MariosVasileiou/EDUV/Website/images/aegean.png

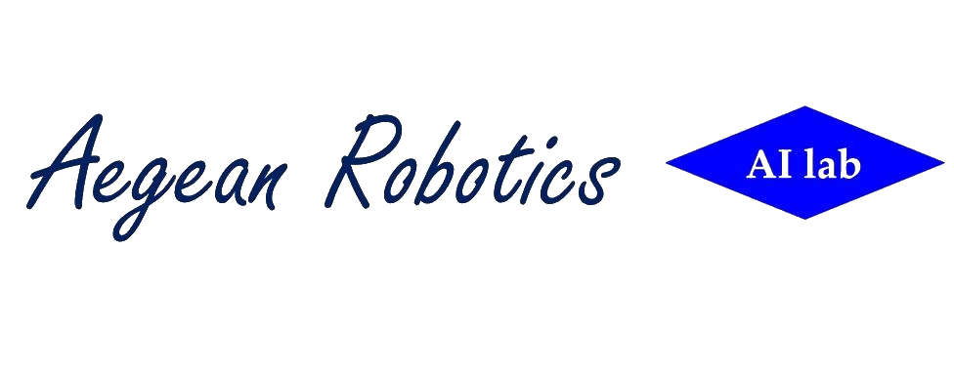
Website/images/aegean.png
