MariosVasileiou/EDUV/Website/images/animation.gif

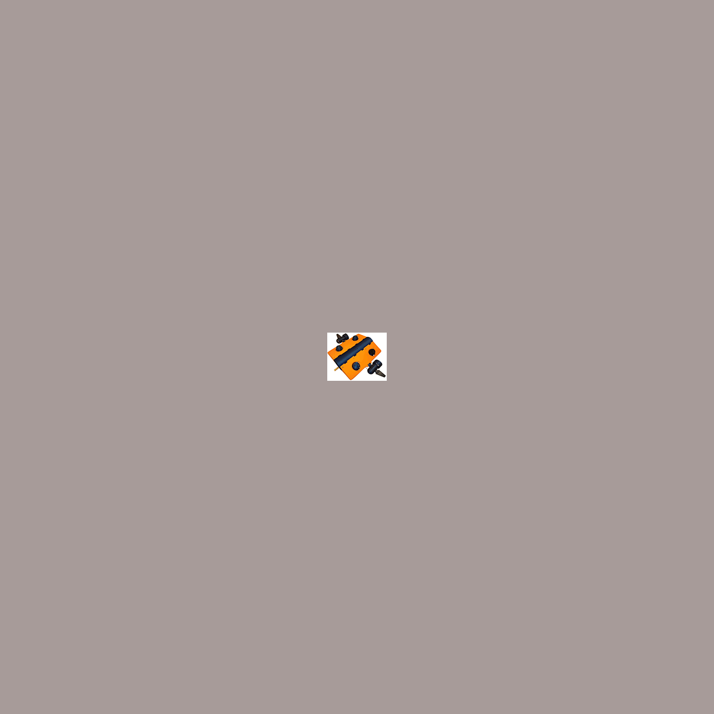
Website/images/animation.gif
