MariosVasileiou/EDUV/Website/images/EDUVButton.png

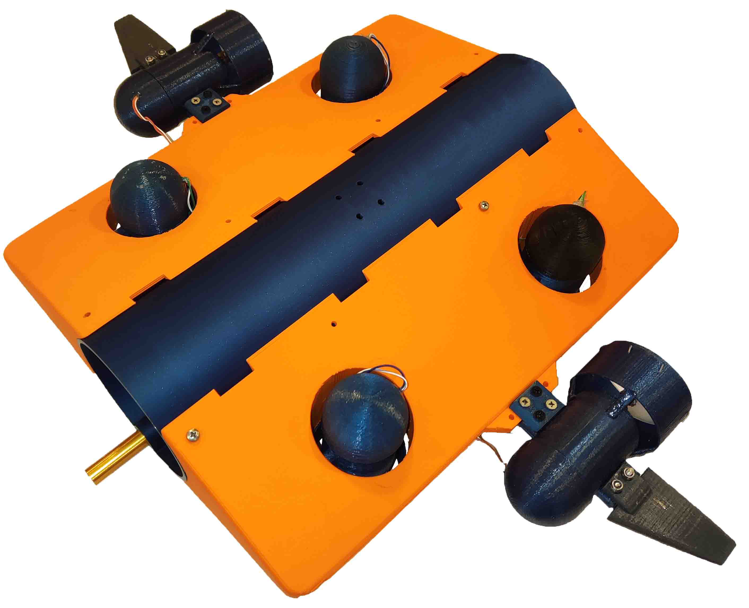
Website/images/EDUVButton.png
