MariosVasileiou/EDUV/Website/images/elgrecoPlay.png

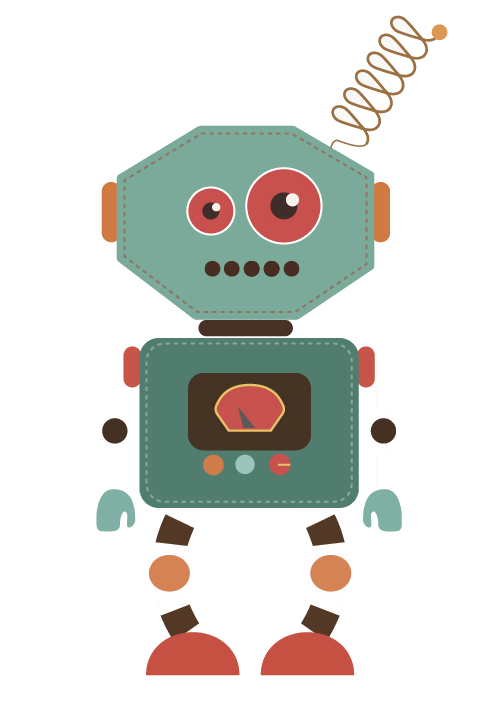
Website/images/elgrecoPlay.png
