MariosVasileiou/EDUV/Website/images/empty - Copy.png

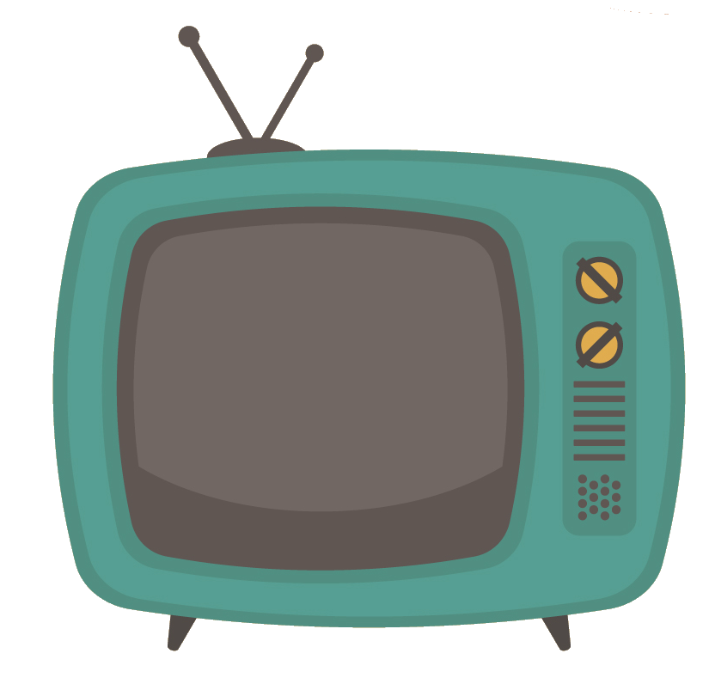
Website/images/empty - Copy.png
