MariosVasileiou/EDUV/Website/images/end.png

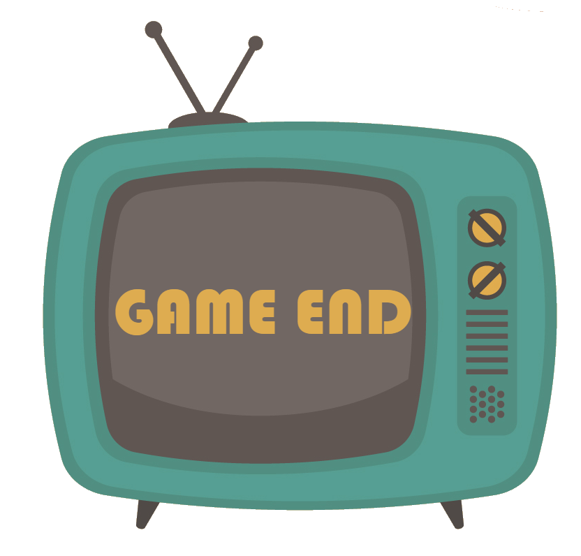
Website/images/end.png
