MariosVasileiou/EDUV/Website/images/fail.png

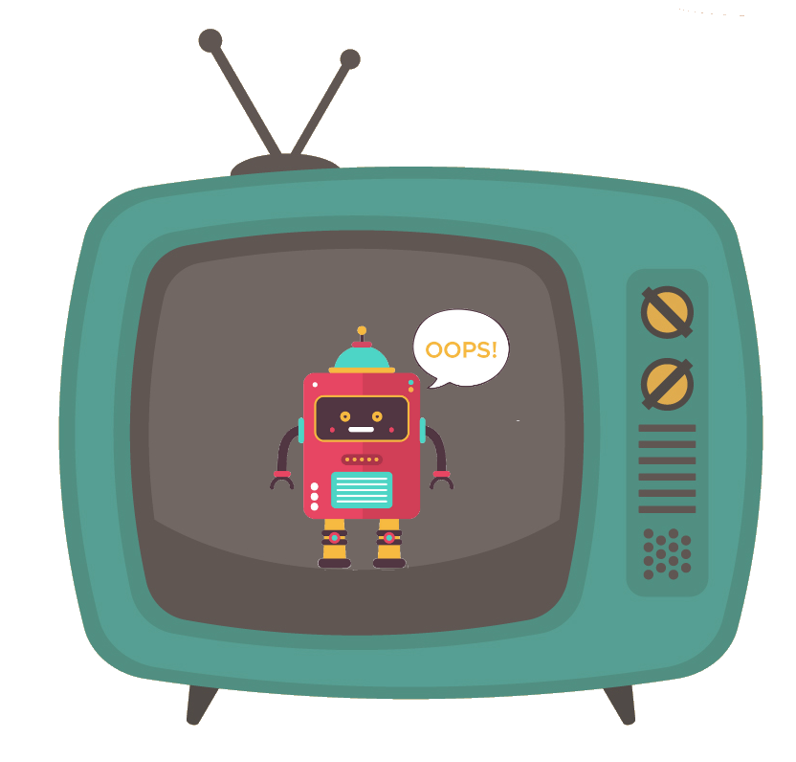
Website/images/fail.png
