MariosVasileiou/EDUV/Website/images/info2.png

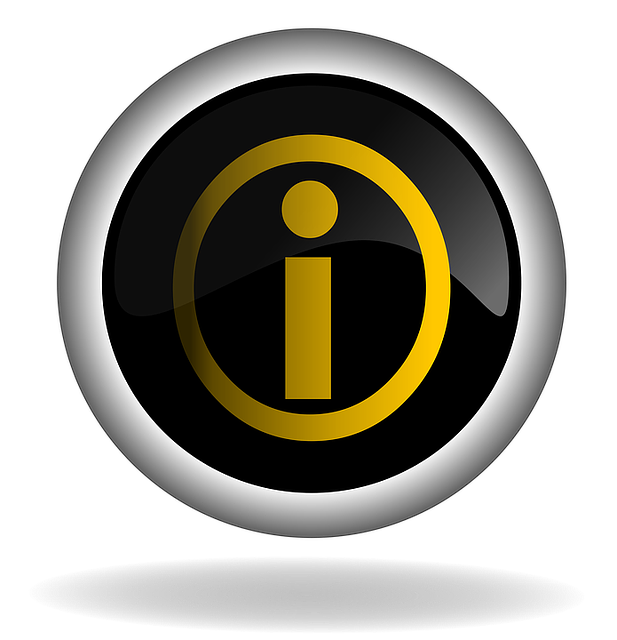
Website/images/info2.png
