MariosVasileiou/EDUV/Website/images/introtext.gif

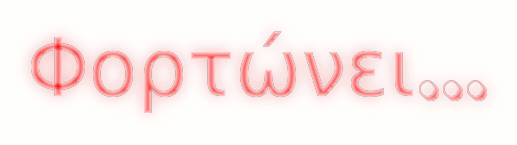
Website/images/introtext.gif
