MariosVasileiou/EDUV/Website/images/map.jpg

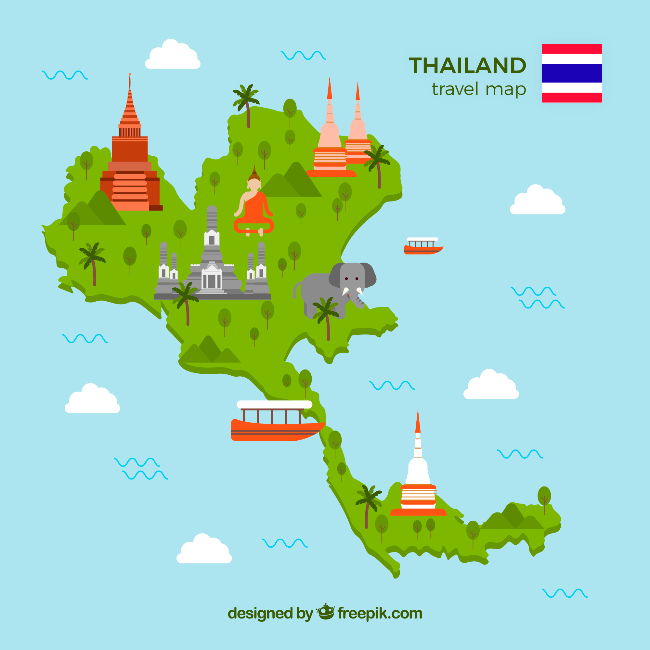
Website/images/map.jpg
