MariosVasileiou/EDUV/Website/images/pushbutton.png

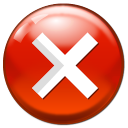
Website/images/pushbutton.png
