MariosVasileiou/EDUV/Website/images/rb1.png

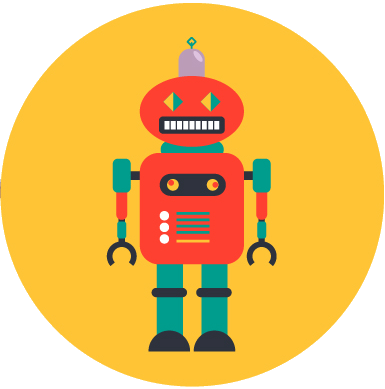
Website/images/rb1.png
