MariosVasileiou/EDUV/Website/images/rb2.png

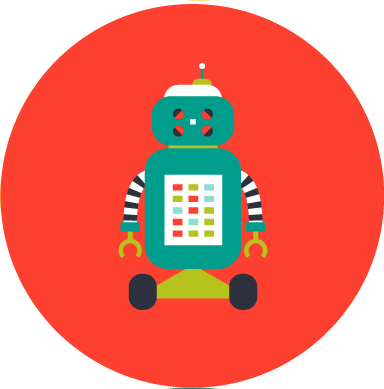
Website/images/rb2.png
