MariosVasileiou/EDUV/Website/images/rb3.png

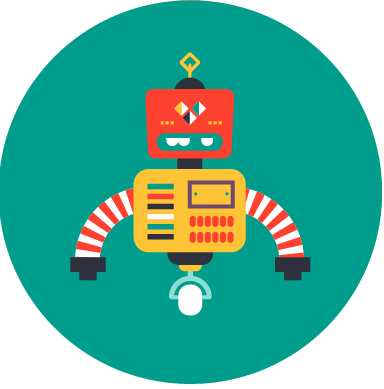
Website/images/rb3.png
