MariosVasileiou/EDUV/Website/images/slider1.jpg

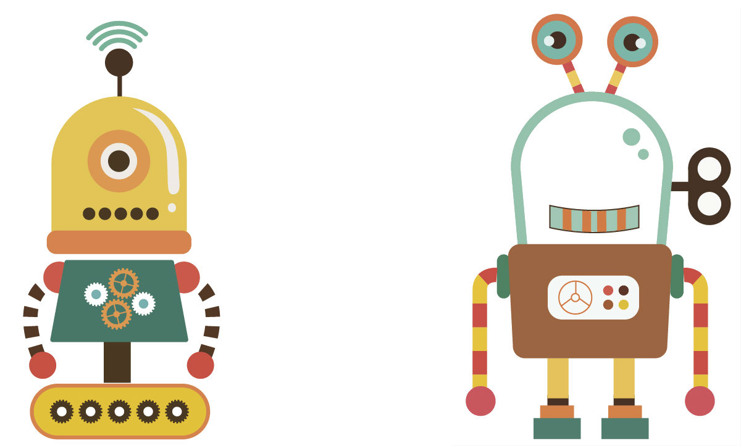
Website/images/slider1.jpg
