MariosVasileiou/EDUV/Website/images/start.png

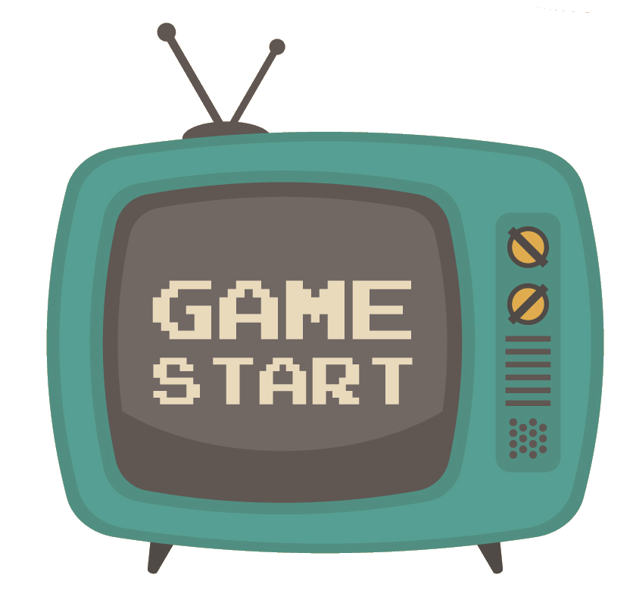
Website/images/start.png
