MariosVasileiou/EDUV/Website/images/success.png

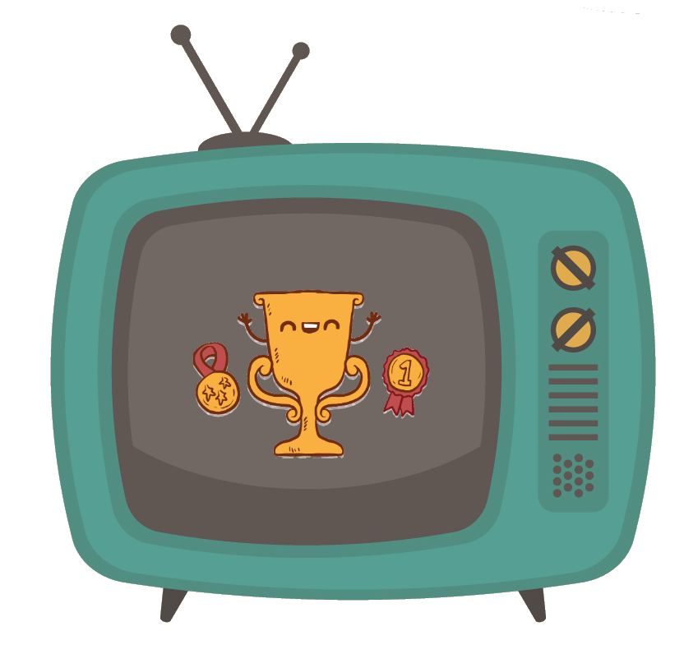
Website/images/success.png
