MariosVasileiou/EDUV/Website/images/timerHeader.png

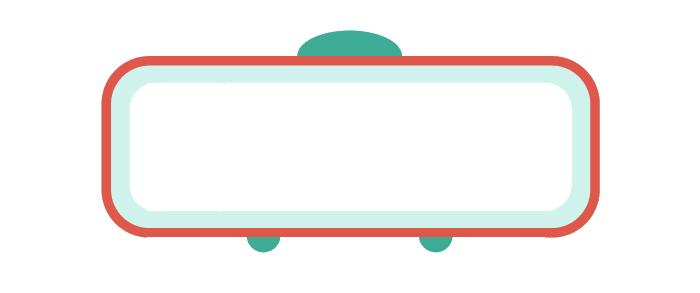
Website/images/timerHeader.png
