MariosVasileiou/EDUV/3D Models/EDUV-fin.stl

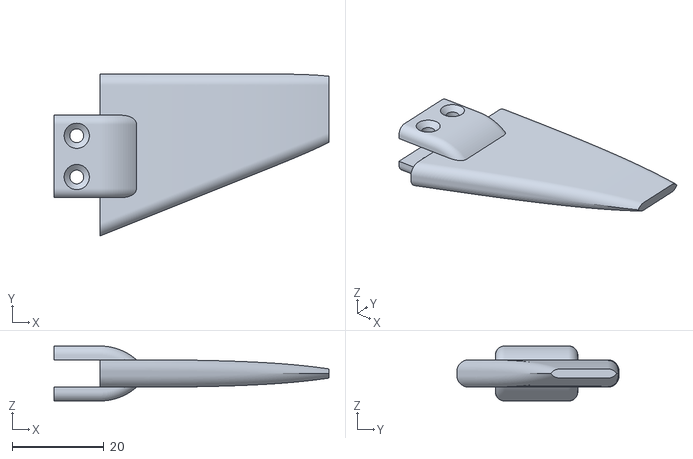
[picture p23: CAD file, 2023-04-15]
3D Models/EDUV-fin.stl
60.0 x 35.4 x 12.0
