MariosVasileiou/EDUV/3D Models/EDUV-right_part.stl

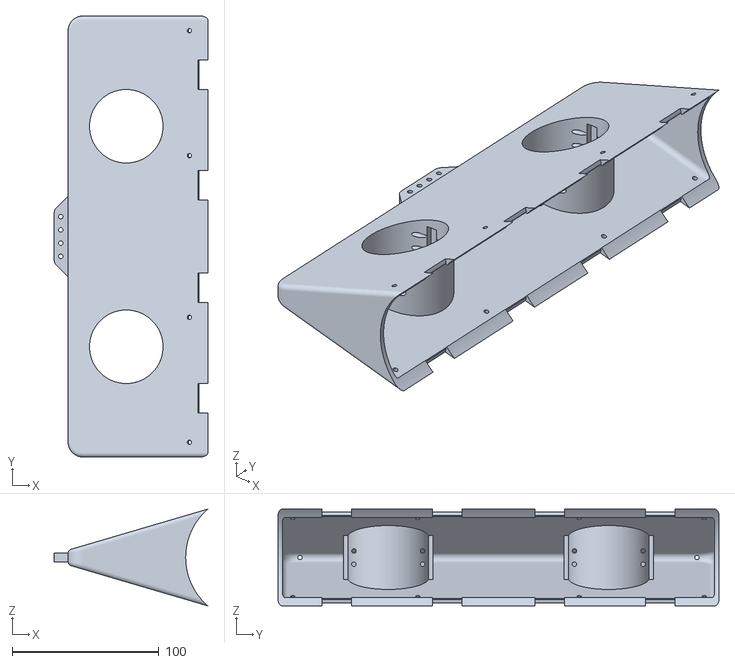
[picture p24: CAD file, 2023-04-15]
3D Models/EDUV-right_part.stl
104.6 x 300.0 x 65.9
