MariosVasileiou/EDUV/3D Models/EDUV-center_cylinder.stl

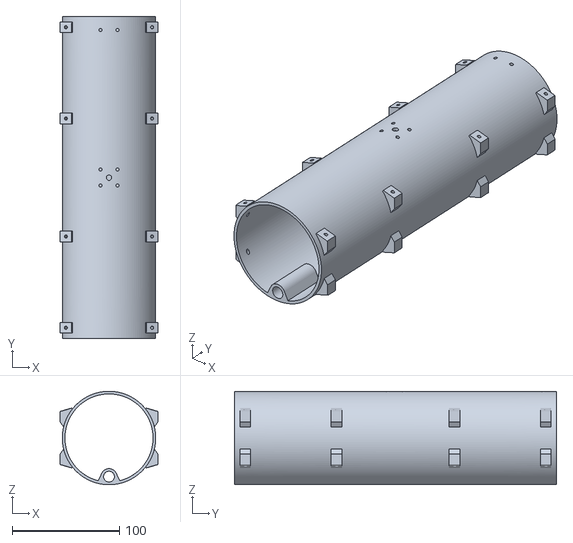
[picture p25: CAD file, 2023-04-15]
3D Models/EDUV-center_cylinder.stl
91.3 x 300.0 x 87.0
