MariosVasileiou/EDUV/(list of files, cad)

Other CAD files:
3D Models/EDUV-left_part.stl
